cutlasses/Looper/Build/PIC Button Strip Schematic.png

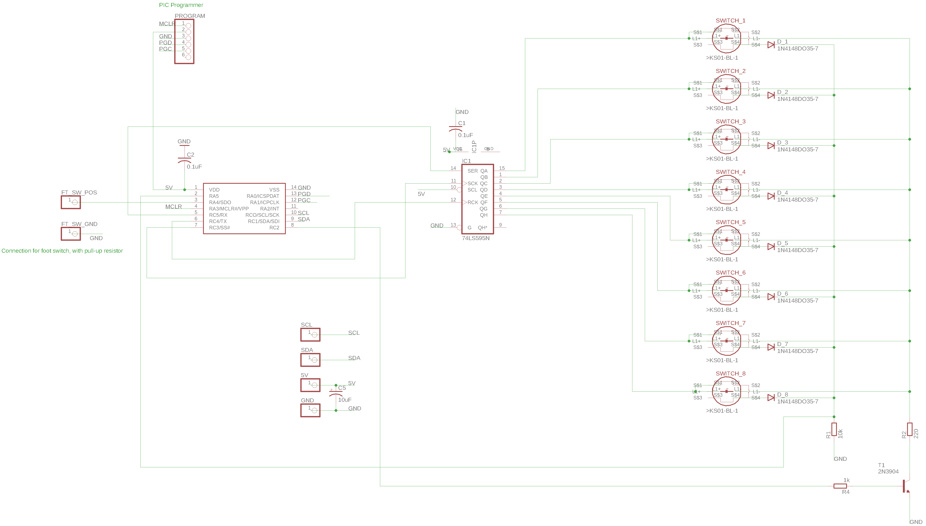
Build/PIC Button Strip Schematic.png
