cutlasses/Looper/(commit log)

2018-10-19 Adding ButtonStrip
2018-10-19 Tying in button strip (not working yet)
    [ButtonStrip.cpp, ButtonStrip.h, Looper.ino, SDAudioRecorder.cpp, SDAudioRecorder.h]
2018-10-20 Sample jumping now works!!
2018-10-20 Adding currently unsused interface files
2018-10-20 Removing unecessary prints
2018-10-22 Adding recording (not currently working)
2018-10-23 Implementing a record queue
    A copy of the Teensy one without needing to be an effect.
    Need to implement the audio functions
2018-10-25 Fixing flicker
    I2C is now only updated every 25ms
    [ButtonStrip.cpp, ButtonStrip.h]
2018-10-25 Syncing button strip to record time
    Also, only LEDs get updated at a lower rate via I2C to fix flickering. Hopefully temporary
    [ButtonStrip.cpp, ButtonStrip.h, Looper.ino, SDAudioRecorder.cpp, SDAudioRecorder.h]
2018-11-24 Update Build/PIC Button Strip Schematic.png
2018-12-16 More work on overdubbing
    Still not working!
    [Looper.ino, SDAudioRecorder.cpp]
2018-12-27 More looper fixes
    Still WIP
    [Looper.ino, SDAudioRecorder.cpp, SDAudioRecorder.h]
2018-12-28 More fixes
    Still not audio tested
    Is is failing to write the last sector?
    Ratify need for irq enable/disable
    [SDAudioRecorder.cpp, SDAudioRecorder.h]
2018-12-29 Fixing bug with blocks not being recorded
    One block still sometimes missed?
    [SDAudioRecorder.cpp]
2019-01-27 Button strip fixes
    Debounce now works properly
    Deals with I2C not returning data (not sure why this happens though)
    [ButtonStrip.cpp, ButtonStrip.h, Looper.ino]
2019-01-28 Minor fixes
    Adding gain reduction on input (currently fixed)
    Removing unecessary irq enable/disable
    [Looper.ino, SDAudioRecorder.cpp]
2019-01-29 Moving file access out of interrupts
    NOT CURRENTLY WORKING
2019-02-01 Added schematic
2019-02-06 Refactor!!
    Massive refactor - all SD card access now happens outside of the audio interrupts. NOT YET WORKING
2019-02-09 Improving buffering
    Simple balancing system to keep play queue from emptying whilst preventing record queue from getting full
    [ButtonStrip.cpp, SDAudioRecorder.cpp, SDAudioRecorder.h]
2019-02-09 Locking button strip when recording
2019-02-11 Fix for initial writing
    [SDAudioRecorder.cpp, Util.h]
2019-02-16 Fixing button bug (untested)
    Also making a start on sequence recording
    [ButtonStrip.cpp, ButtonStrip.h, Looper.ino]
2019-04-27 Fix for soft clip
    Was summing in 16 bits and getting wrap around
    [Looper.ino, SDAudioRecorder.cpp, Util.h]
2019-04-28 Bug fix
    Fix for sequence length not being reset
    [ButtonStrip.cpp, ButtonStrip.h]
2019-04-28 Adding delay pots
    Adding filter to delay time pot
2019-04-28 Adding clear_sequence()
    Still bug hunting
    [ButtonStrip.cpp, ButtonStrip.h, Looper.ino, LooperInterface.cpp, LooperInterface.h]
2019-04-29 Bug fixed?
    Now properly starting the played audio
    Not stopping record on mode change
    [Looper.ino, LooperInterface.cpp, SDAudioRecorder.cpp]
2019-05-01 Minor fixes
    Reverting change to wait for play queue to empty
    Fixed some bugs regarding state changes
    Added threshold to TIMED_SECTION
    [AudioRecordQueue.h, ButtonStrip.h, Looper.ino, SDAudioRecorder.cpp, Util.h]
2019-05-28 Fixes to playback speed
    Now appears to be working
    [SDAudioRecorder.cpp]
2019-06-20 Fix for overidden segment
    Currently not overidding
    [ButtonStrip.cpp, ButtonStrip.h, Looper.ino]
2019-06-20 Fixing button strip
    Now works with variable speed playback
    [ButtonStrip.cpp, ButtonStrip.h, Looper.ino, SDAudioRecorder.cpp]
